wallawil/CS207/Images/dnd.jpg

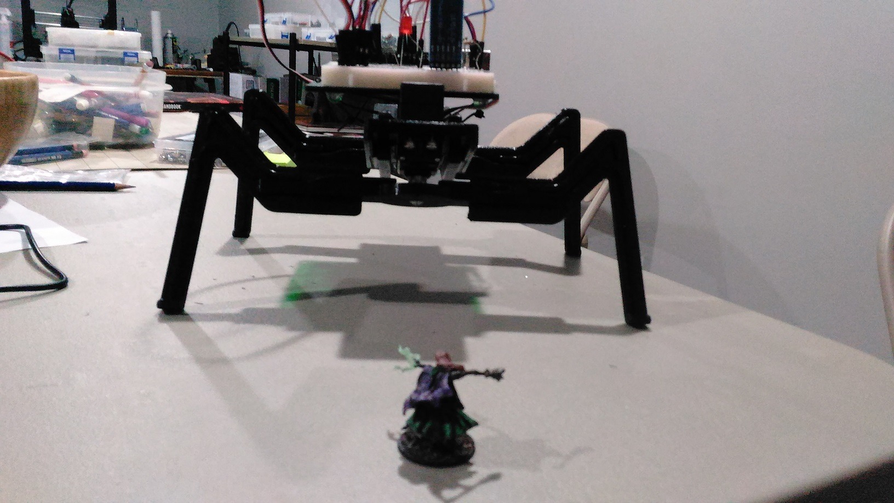
Images/dnd.jpg
