wallawil/CS207/Images/exoskeleton.jpg

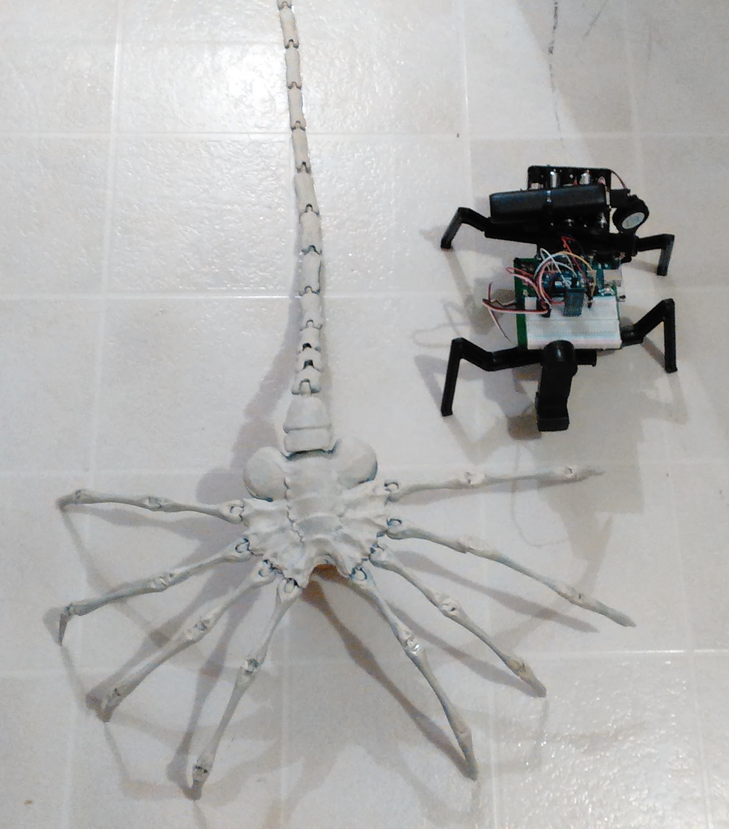
Images/exoskeleton.jpg
