wallawil/CS207/Images/ver3.png

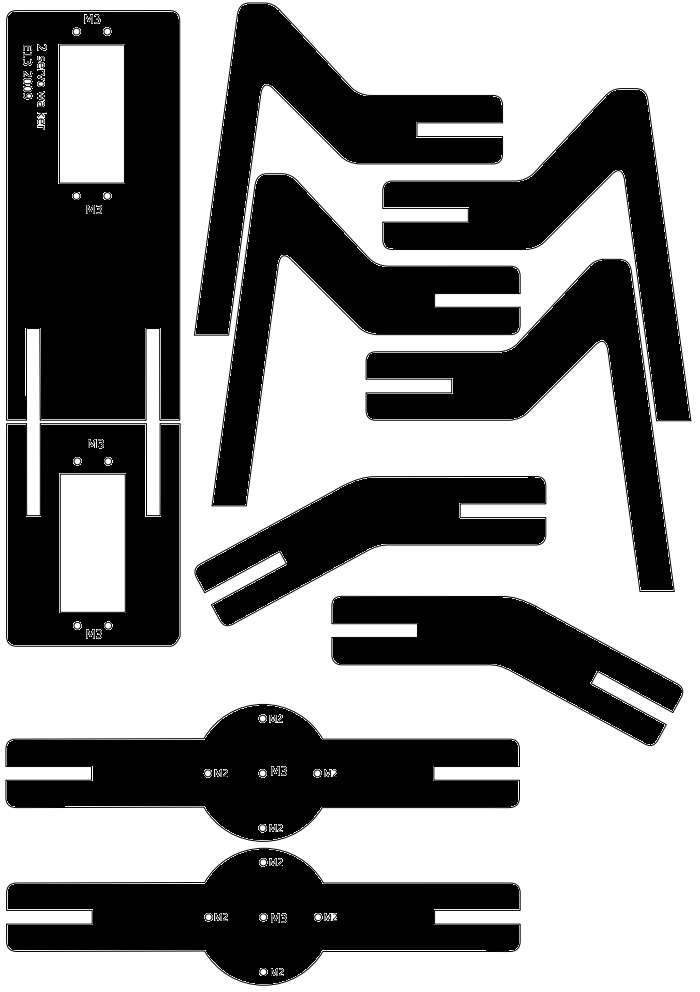
Images/ver3.png
