wallawil/CS207/Images/parts.jpg

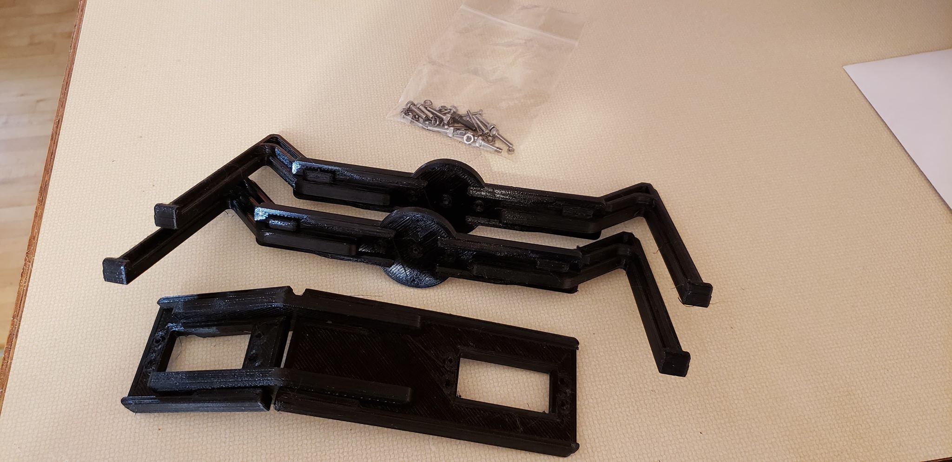
Images/parts.jpg
