wallawil/CS207/Images/BluetoothExperiments.png

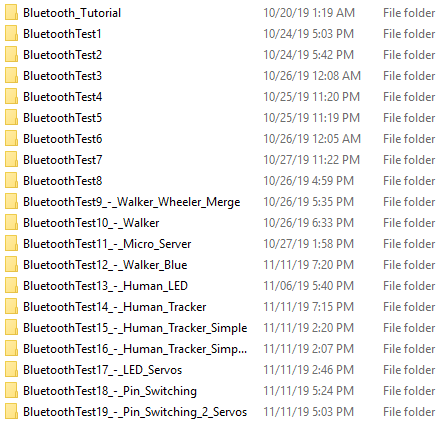
Images/BluetoothExperiments.png
