wallawil/CS207/(commit log)

2019-10-30 Create 4-legged 2-servo robot
2019-11-06 Add files via upload
    BluetoothTest 13 is a test for tracking human movement. This test code does not need a robot or walker; it simply lights up one of 3 LEDs depending on where a human is standing in the viewport (either left, right, or center).
2019-11-11 Create Log 3 - Servo Tinkering
2019-11-11 Update and rename Log 3 - Servo Tinkering to Log 3 - Servo Tinkering.md
2019-11-11 Update and rename Log 3 - Servo Tinkering.md to Log 3 - Servo Tinkering (Milestone 2 met).md
2019-11-11 Update Log 3 - Servo Tinkering (Milestone 2 met).md
2019-11-11 Create Log 4 - Trouble with Servos and Bluetooth.md
2019-11-11 Update Log 4 - Trouble with Servos and Bluetooth.md
2019-11-19 Create Log 6 - Power Problems and Milestone Musings.md
2019-12-03 Less twitchy servos. More efficient functions.
    [BluetoothTest20_-_Crawler.ino]
